alazifi/baby-incubator-tester/KiCAD/IncubatorTesterV7/IncubatorTesterV7.kicad_pcb

## KiCad design KiCAD/IncubatorTesterV7/IncubatorTesterV7.kicad_pcb (2024-07-31)

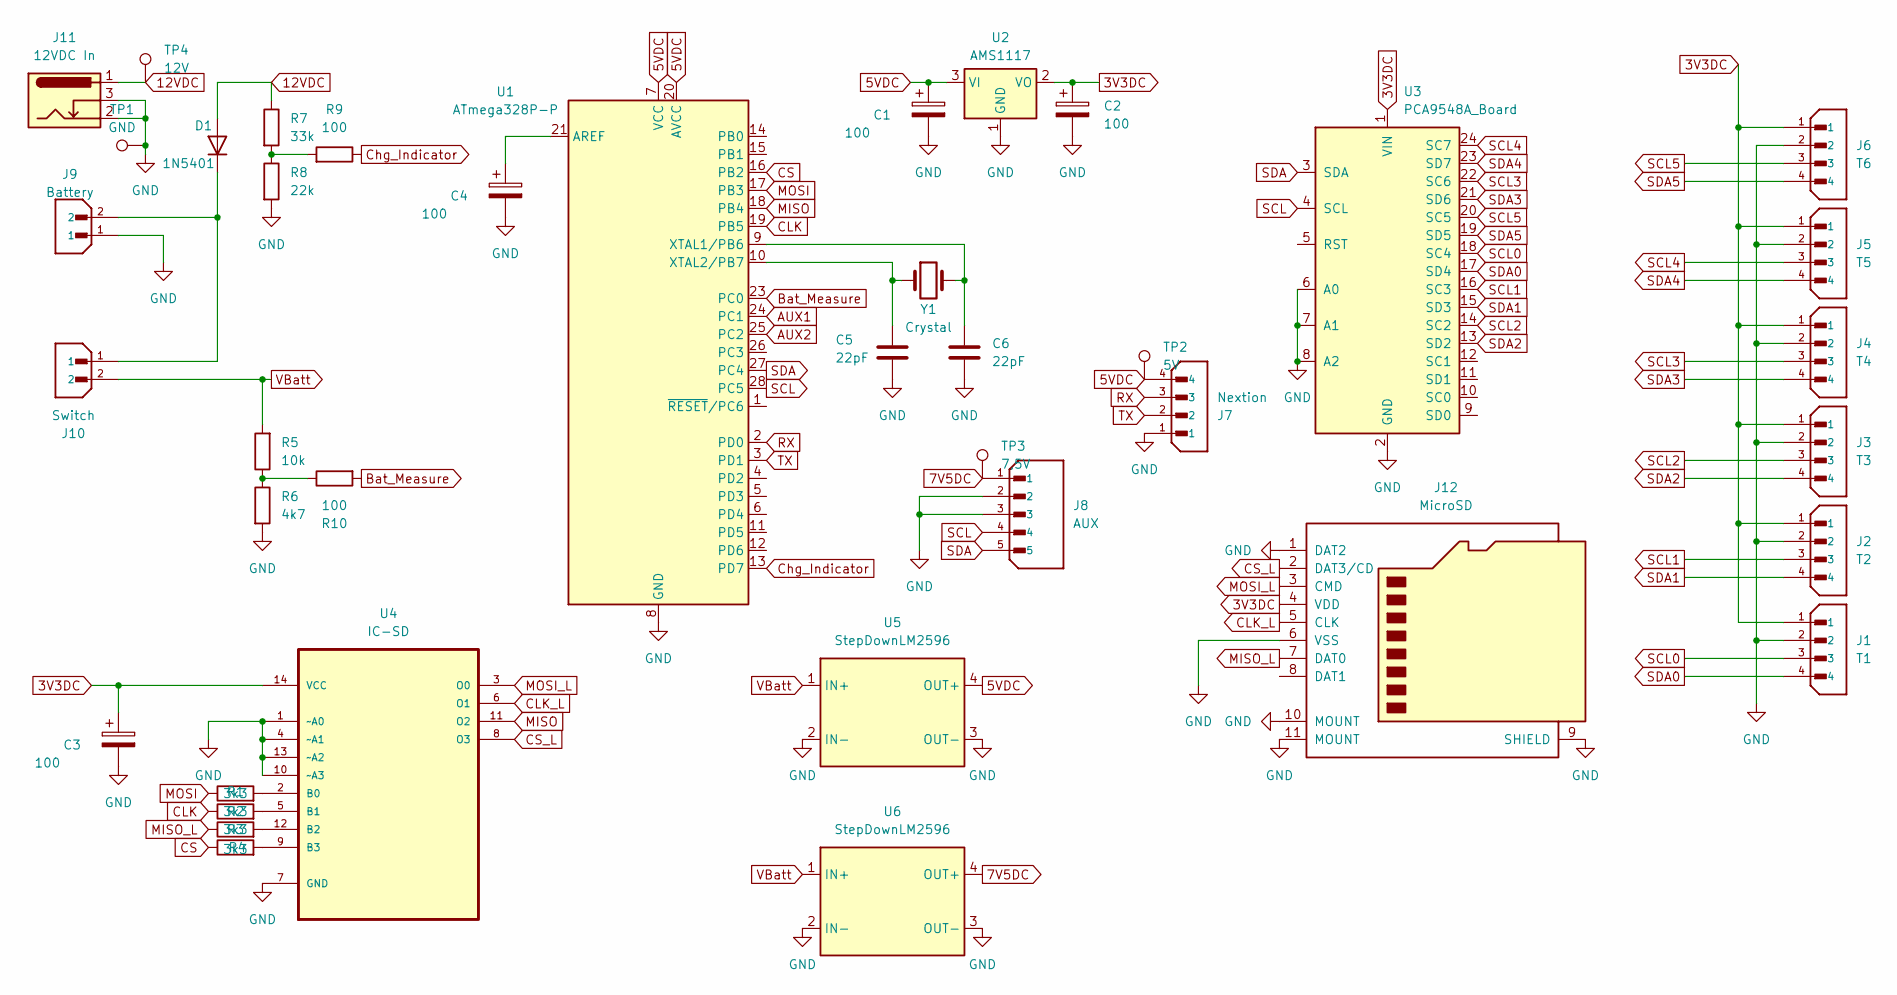
[picture p1: schematic IncubatorTesterV7.kicad_sch]

Parts:
C1, C2, C3, C4: 100; C_Radial
C5, C6: 22pF; C_Disc_D3.0mm_W1.6mm_P2.50mm
D1: 1N5401; D_DO-201AD_P15.24mm_Horizontal
J1: T1; JST_B4B-XH-A_LF__SN_
J2: T2; JST_B4B-XH-A_LF__SN_
J3: T3; JST_B4B-XH-A_LF__SN_
J4: T4; JST_B4B-XH-A_LF__SN_
J5: T5; JST_B4B-XH-A_LF__SN_
J6: T6; JST_B4B-XH-A_LF__SN_
J7: Nextion; JST_B4B-XH-A_LF__SN_
J8: AUX; JST_B5B-XH-A_LF__SN_; PARTREV 7/4/21
J9: Battery; JST_XH_S2B-XH-A_1x02_P2.50mm_Horizontal
J10: Switch; JST_B2B-XH-A
J11: 12VDC In; BarrelJack_Horizontal
J12: MicroSD; HRS_DM3AT-SF-PEJM5; PARTREV 20200913
R1, R2, R3, R4: 3k3; R_Axial
R5: 10k; R_Axial
R6: 4k7; R_Axial
R7: 33k; R_Axial
R8: 22k; R_Axial
R9, R10: 100; R_Axial
TP1: GND; TestPoint_Pad_D2.0mm
TP2: 5V; TestPoint_Pad_D2.0mm
TP3: 7,5V; TestPoint_Pad_D2.0mm
TP4: 12V; TestPoint_Pad_D2.0mm
U1: ATmega328P-P; DIP-28_W7.62mm
U2: AMS1117; SOT-223-3_TabPin2
U3: PCA9548A_Board; PCA9548A
U4: IC-SD; SOIC127P600X175-14N; MPN 74VHC125M
U5, U6: StepDownLM2596; Step_Down_DCDC
Y1: Crystal; Crystal_HC49-4H_Vertical

Connections:
3V3DC: C2.1, C3.1, J1.1, J2.1, J3.1, J4.1, J5.1, J6.1, J12.4 (VDD), U2.2 (VO), U3.1 (VIN), U4.14 (VCC)
5VDC: C1.1, J7.4, TP2.1, U1.7 (VCC), U1.20 (AVCC), U2.3 (VI), U5.4 (OUT+)
7V5DC: J8.1, TP3.1, U6.4 (OUT+)
12VDC: D1.2 (A), J11.1, R7.1, TP4.1
AUX1: U1.24 (PC1)
AUX2: U1.25 (PC2)
Bat_Measure: R10.2, U1.23 (PC0)
CLK: R2.1, U1.19 (PB5)
CLK_L: J12.5 (CLK), U4.6 (O1)
CS: R4.1, U1.16 (PB2)
CS_L: J12.2 (DAT3/CD), U4.8 (O3)
Chg_Indicator: R9.1, U1.13 (PD7)
GND: C1.2, C2.2, C3.2, C4.2, C5.2, C6.2, J1.2, J2.2, J3.2, J4.2, J5.2, J6.2, J7.1, J8.2, J8.3, J9.1, J11.2, J11.3, J12.1 (DAT2), J12.6 (VSS), J12.9 (SHIELD), J12.10 (MOUNT), J12.11 (MOUNT), R6.2, R8.2, TP1.1, U1.8 (GND), U1.22 (GND), U2.1 (GND), U3.2 (GND), U3.6 (A0), U3.7 (A1), U3.8 (A2), U4.1 (~A0), U4.4 (~A1), U4.7 (GND), U4.10 (~A3), U4.13 (~A2), U5.2 (IN-), U5.3 (OUT-), U6.2 (IN-), U6.3 (OUT-)
MISO: U1.18 (PB4), U4.11 (O2)
MISO_L: J12.7 (DAT0), R3.1
MOSI: R1.1, U1.17 (PB3)
MOSI_L: J12.3 (CMD), U4.3 (O0)
unnamed: D1.1 (K), J9.2, J10.1
unnamed: R7.2, R8.1, R9.2
unnamed: R5.1, R6.1, R10.1
unnamed: C4.1, U1.21 (AREF)
unnamed: C6.1, U1.9 (XTAL1/PB6), Y1.2
unnamed: C5.1, U1.10 (XTAL2/PB7), Y1.1
unnamed: R1.2, U4.2 (B0)
unnamed: R2.2, U4.5 (B1)
unnamed: R3.2, U4.12 (B2)
unnamed: R4.2, U4.9 (B3)
RX: J7.3, U1.2 (PD0)
SCL: J8.4, U1.28 (PC5), U3.4 (SCL)
SCL0: J1.3, U3.18 (SC4)
SCL1: J2.3, U3.16 (SC3)
SCL2: J3.3, U3.14 (SC2)
SCL3: J4.3, U3.22 (SC6)
SCL4: J5.3, U3.24 (SC7)
SCL5: J6.3, U3.20 (SC5)
SDA: J8.5, U1.27 (PC4), U3.3 (SDA)
SDA0: J1.4, U3.17 (SD4)
SDA1: J2.4, U3.15 (SD3)
SDA2: J3.4, U3.13 (SD2)
SDA3: J4.4, U3.21 (SD6)
SDA4: J5.4, U3.23 (SD7)
SDA5: J6.4, U3.19 (SD5)
TX: J7.2, U1.3 (PD1)
VBatt: J10.2, R5.2, U5.1 (IN+), U6.1 (IN+)

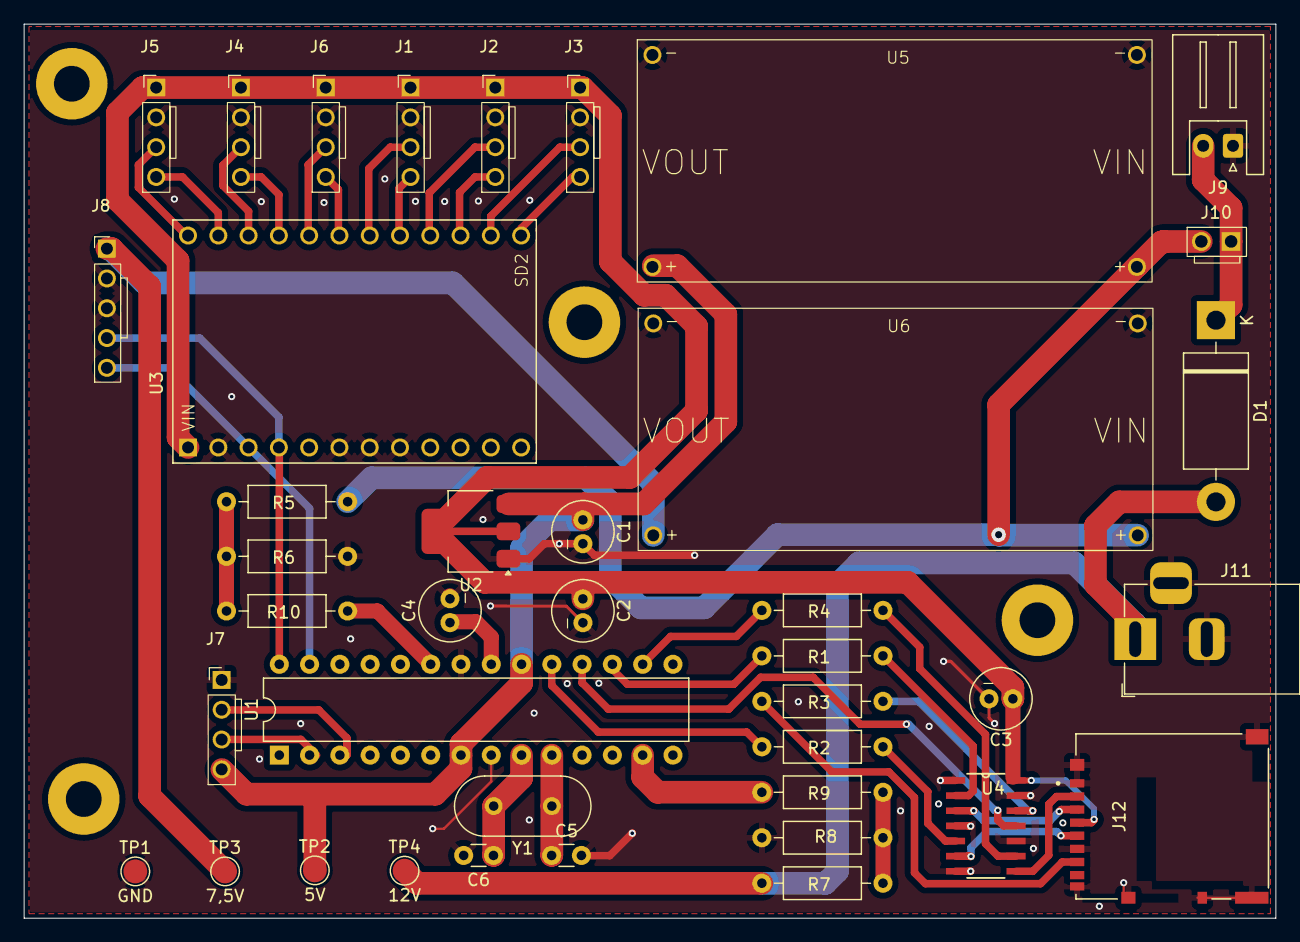
[picture p2: board IncubatorTesterV7.kicad_pcb from above]

Board: 2 copper layers, 105.0 x 75.0 mm, 40 parts (0 on the bottom side), 42 nets.
